Arctos6135/BeautifulRobot/sch/BeautifulRobot.sch

## EAGLE design sch/BeautifulRobot.sch (2019-03-05)

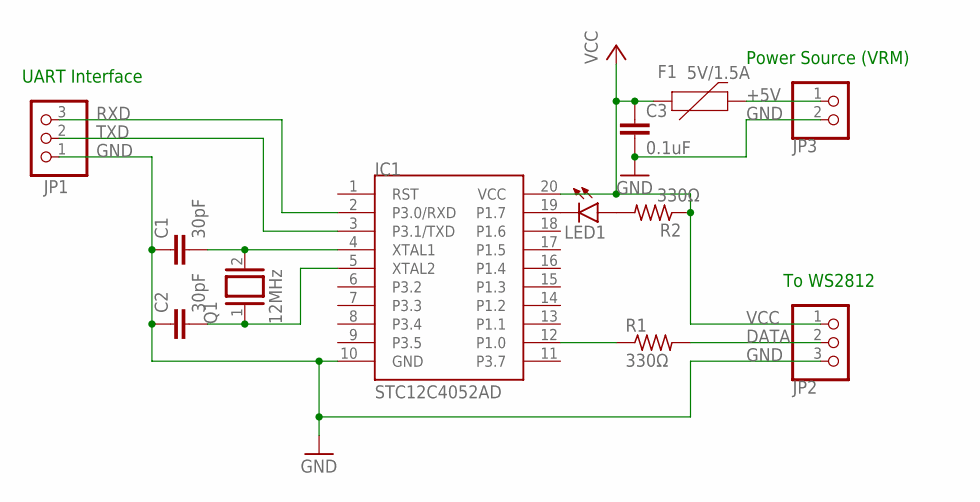
[picture p1: schematic BeautifulRobot.sch]

Parts:
C1, C2: 30pF; C025-025X050
C3: 0.1uF; C025-025X050
F1: 5V/1.5A; PTH
IC1: STC12C4052AD; DIP762W40P254L2606H508Q20B
JP1, JP2: PINHD-1X3; 1X03
JP3: PINHD-1X2; 1X02
LED1: LED5MM
Q1: 12MHz; QS
R1, R2: 330Ω; 0204/7

Connections:
+5V: F1.P$2 (2), JP3.1
DATA: JP2.2, R1.2
GND: C1.1, C2.1, C3.2, IC1.10 (GND), JP1.1, JP2.3, JP3.2
unnamed: C2.2, IC1.5 (XTAL2), Q1.1
unnamed: C1.2, IC1.4 (XTAL1), Q1.2
unnamed: IC1.12 (P1.0), R1.1
unnamed: LED1.A, R2.2
unnamed: IC1.19 (P1.7), LED1.K (C)
RXD: IC1.2 (P3.0/RXD), JP1.3
TXD: IC1.3 (P3.1/TXD), JP1.2
VCC: C3.1, F1.P$1 (1), IC1.20 (VCC), JP2.1, R2.1

Notes on the sheet:
UART Interface
To WS2812
Power Source (VRM)
