Arctos6135/BeautifulRobot/(commit log)

2019-01-01 Add spi.c and spi.h
2019-01-01 Add SPI test code and LED reset code
    [main.c, ws2812b.c, ws2812b.h]
2019-01-01 Add code for UART
2019-01-02 Re-add interrupts
2019-01-03 Add a sync byte to each command
    Each command is now 3 instead of 2 bytes. A third byte, the "sync byte",
    is added to the end of the message. It has the value 0xFF and is used to
    verify that all bytes were sent properly. This fixes the problem that
    if one byte was missed, all subsequent messages would be messed up due
    to the first message not having enough bytes, and thus remaining in the
    buffer.
    [main.c, uart.c, uart.h]
2019-01-03 Refactor to remove usage of times[] array
    The times[] array is uncecessary as the time of every LED can be
    calculated from the time of the one before it. It has been changed to a
    single global variable, time, and a temporary variable inside the
    color generation function that gets incremented.
2019-01-03 Add new "direction" command
    The new "direction" command (0x05) controls the direction of the pulse
    in modes such as 2 and 3. In direction 0 (the default), the pulse moves
    down the LED strip and follows its direction. In direction 1, the pulse
    moves from the end of the LED strip and back towards the beginning.
2019-01-03 Add new "LED count" command
    This new command (0x06) sets the amount of LEDs controlled to the value
    of the parameter. The parameter must be in the range [0, 80], as the
    color buffer is only enough to fit 80 LEDs maximum.
2019-01-03 Add schematic
    Schematic located under sch/ and comes with its own gitignore.
    [BeautifulRobot.sch]
2019-01-03 Schematic revision 2
    Move resettable fuse to only affect the WS2812B.
    [BeautifulRobot.sch]
2019-01-03 Update README to include schematic
    Add a picture of the schematic in the README and notes to go along with
    it.
2019-01-03 Delete unused SPI source files
    Delete spi.c and spi.h since SPI is no longer used in this project.
2019-01-04 Update README
    Add note warning about unintended behavior when changing the LED count
    when the strip is on, and add rows in the operations/parameters table
    for the new speed setting commands.
2019-01-04 Add new "reset" command
    This new reset command (0x09) takes no parameters and performs a soft
    reset on the microcontroller, leading all properties such as brightness
    to be reset back to the default.
    [BeautifulRobot.java, main.c]
2019-01-06 Move fuse in schematic to include the whole circuit
    The resettable fuse was moved so that now it lies before the whole
    circuit rather than just the LED strip. This means that in case of
    overcurrent, the MCU will lose power and be reset, which will cause it
    to start back up with all the LEDs off.
    [BeautifulRobot.sch]
2019-01-06 Add missing resistor in schematic
    Add missing 330R resistor in the data line of the WS2812B. README.md is
    also updated.
    [BeautifulRobot.sch]
2019-01-06 Update README.md
    Include finished circuit picture and notes, and additional UART
    interface details.
2019-01-07 Improve FRC Java example
    Modify examples/BeautifulRobot.java so now the checked writes will try
    again if the BeautifulRobot failed to respond within 100ms. Also add
    methods that allow concurrent command writing.
    [BeautifulRobot.java]
2019-01-22 Change reset to 255 for room to add more commands
    [main.c]
2019-01-23 Fix a bunch of weird up formatting and add drawPoint(position, distance)
    [main.c]
2019-01-23 Fix names of register stuff
    [main.c]
2019-01-27 Fix formatter errors and compilation errors
    Fix formatter screw-up and temporarily comment out drawPoint due to its
    compilation error.
    [main.c]
2019-01-28 Fix error with drawPoint
    [main.c]
2019-02-05 Fix drawPoint's compilation error
    [main.c]
2019-02-18 Add custom colour commands and fix bug
    [main.c]
2019-03-05 Update schematic to add new indicator light
    [BeautifulRobot.sch]
